Redear/LeoGamer/Gamer.jpg

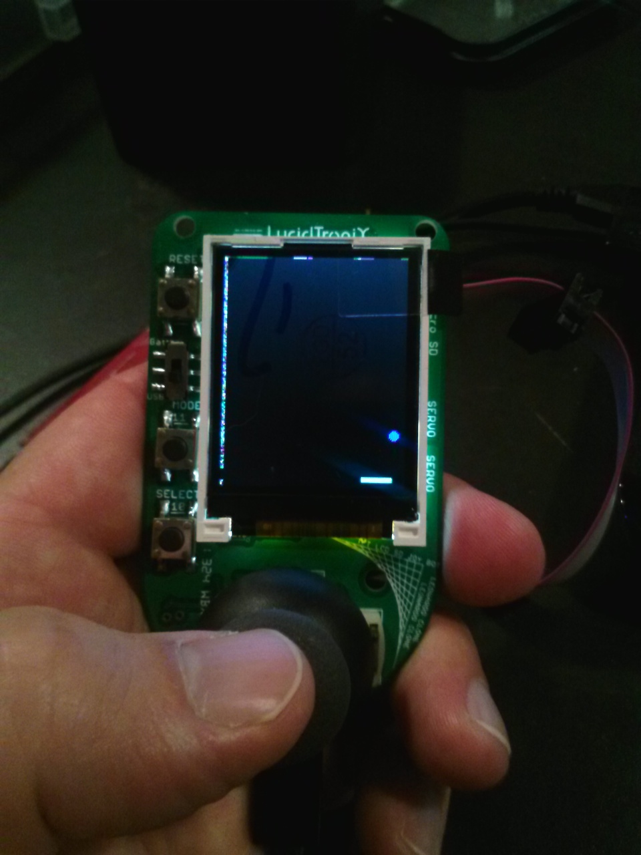
Gamer.jpg
