Redear/LeoGamer/README.md

LeoGamer
========

Arduino Leonardo based gaming system with joystick and MicroSD Card
