Redear/LeoGamer/ST7735.h.png

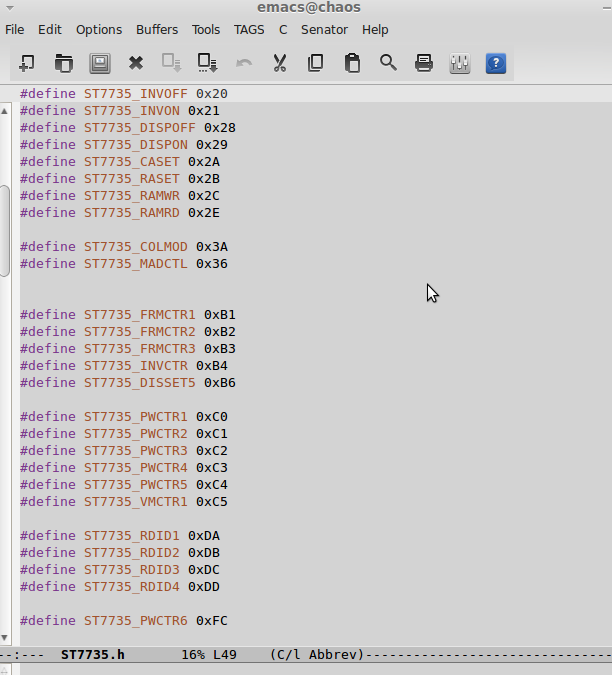
ST7735.h.png
