Redear/LeoGamer/(list of files, cad)

Other CAD files:
meshes/leo_gamer_piezo_hand.blend
meshes/leo_gamer_piezo_hand2.blend
