Redear/LeoGamer/eagle/leo_joy_gamer_v2.brd

## EAGLE design eagle/leo_joy_gamer_v2.brd (2013-09-10)

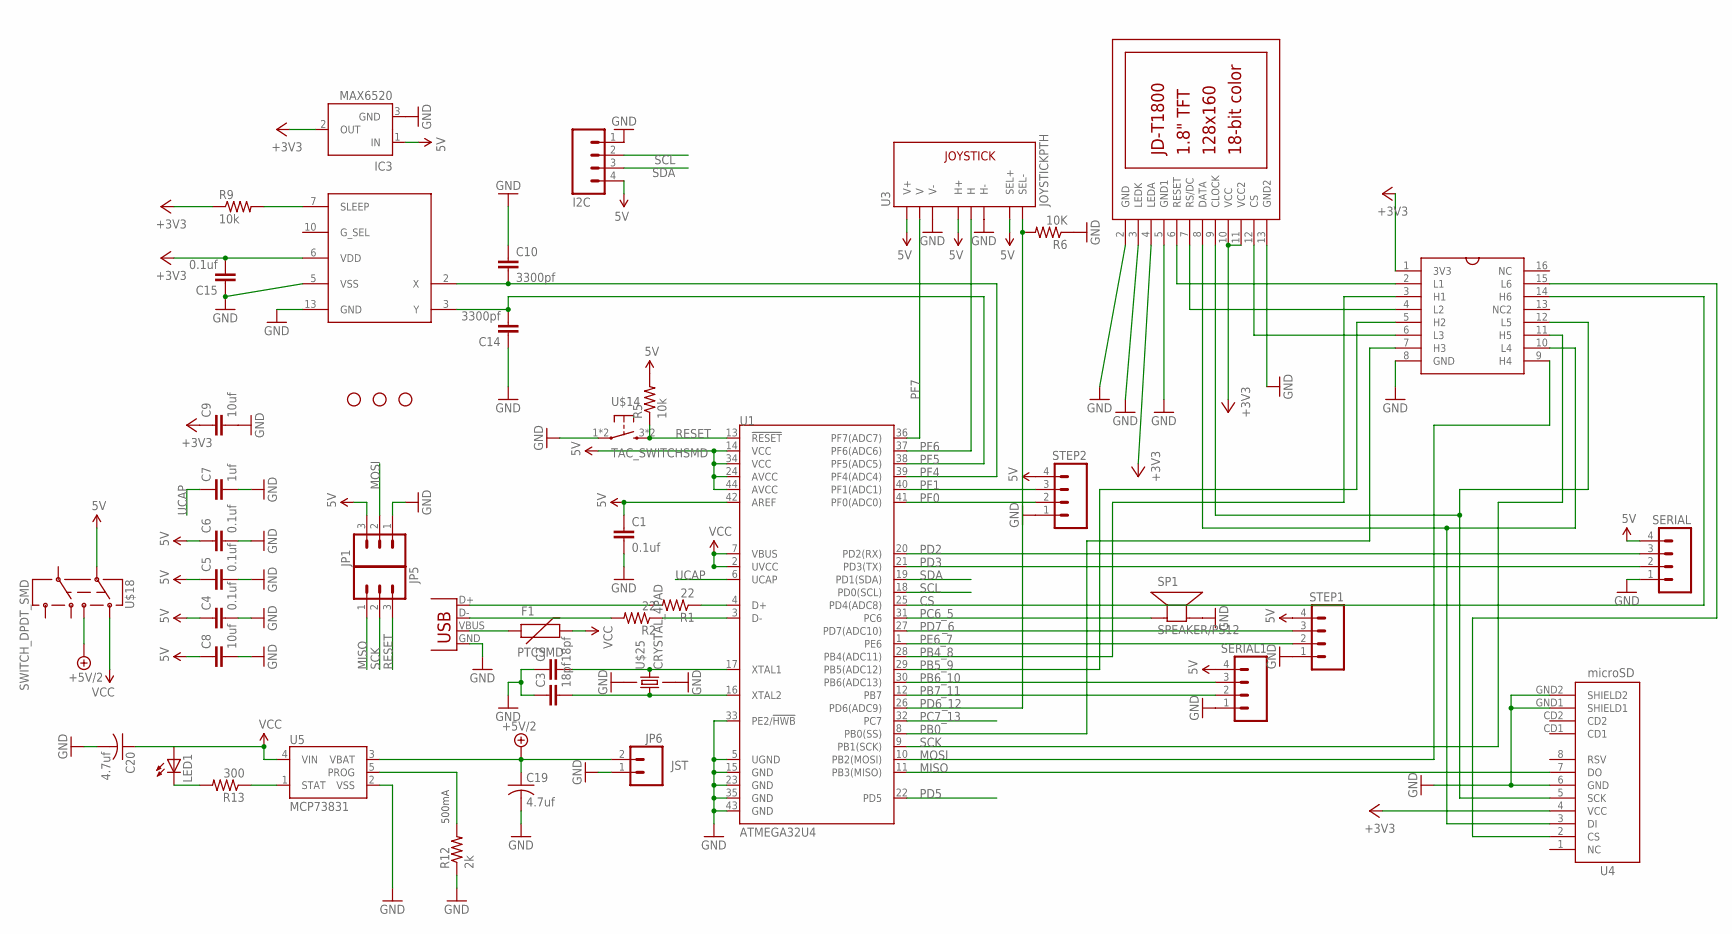
[picture p3: schematic leo_joy_gamer_v2.sch]

Parts:
C1, C4, C5, C6, C15: 0.1uf; 0805
C2, C3: 18pf; 0805
C7: 1uf; 0805
C8, C9: 10uf; 0805
C10, C14: 3300pf; 0805
C19, C20: 4.7uf; C0603
F1: PTCSMD; PTC-1206
I2C: M04LOCK; 1X04_LOCK
IC3: MAX6520; SOT23
JP1, JP5: M03LOCK; 1X03_LOCK
JP2, JP3, JP4: STAND-OFF
JP6: JST; JST-2-PTH
LCD1: JD-T1800
LED1: LEDCHIPLED_1206; CHIPLED_1206
R1, R2: 22; M0805
R5: 10k; M0805
R6: 10K; R0603
R9: 10k; R0805
R12: 2k; R0805
R13: 300; R0805
SERIAL, SERIAL1: M04LOCK; 1X04_LOCK
SP1: SPEAKER/PS12; PS12
STEP1, STEP2: M04LOCK; 1X04_LOCK
U1: ATMEGA32U4; QFN-44-NOPAD
U3: JOYSTICKPTH; JOYSTICK
U4: microSD; MICRO-SD-SOCKET-PP
U5: MCP73831; SOT23-5
U$2: CD4050SO_16_MIDDLE; SO_16
U$12: ACCELEROMETER_MMA6331L; LGA14
U$14: TAC_SWITCHSMD; TAC_SWITCH_SMD
U$18: SWITCH_DPDT_SMD; SWITCH_DPDT
U$25: CRYSTAL_4PAD; CRYSTAL_4PAD_TINY
X1: USBSMD; USB-MINIB

Connections:
5V: C1.1, C4.1, C5.1, C6.1, C8.1, I2C.4, IC3.1 (IN), JP1.3, R5.2, SERIAL.4, SERIAL1.4, STEP1.4, STEP2.4, U1.14 (VCC), U1.24 (AVCC), U1.34 (VCC), U1.42 (AREF), U1.44 (AVCC), U3.B1A (SEL+), U3.H1 (H+), U3.V1 (V+), U$18.7 (2)
+3V3: C9.1, C15.2, IC3.2 (OUT), LCD1.4 (LEDA), LCD1.10 (VCC), LCD1.11 (VCC2), R9.1, U4.4 (VCC), U$2.1 (3V3), U$12.6 (VDD)
+5V/2: C19.1, JP6.2, U5.3 (VBAT), U$18.8 (3)
CS: U1.25 (PD4(ADC8)), U$2.14 (H6)
D+: R1.2, X1.D+
D-: R2.2, X1.D-
GND: C1.2, C2.1, C3.1, C4.2, C5.2, C6.2, C7.2, C8.2, C9.2, C10.1, C14.1, C15.1, C19.2, C20.2, I2C.1, IC3.3 (GND), JP1.1, JP6.1, LCD1.2 (GND), LCD1.3 (LEDK), LCD1.5 (GND1), LCD1.13 (GND2), R6.1, R12.1, SERIAL.1, SERIAL1.1, SP1.P$2 (-), STEP1.1, STEP2.1, U1.5 (UGND), U1.15 (GND), U1.23 (GND), U1.33 (PE2/!HWB), U1.35 (GND), U1.43 (GND), U3.H3 (H-), U3.V3 (V-), U4.6 (GND), U4.GND1 (SHIELD1), U4.GND2 (SHIELD2), U5.2 (VSS), U$2.8 (GND), U$12.5 (VSS), U$12.13 (GND), U$14.1, U$14.2 (1), U$25.2 (GND2), U$25.4 (GND4), X1.GND
MISO: JP5.1, U1.11 (PB3(MISO)), U4.7 (DO)
MOSI: JP1.2, U1.10 (PB2(MOSI)), U$2.9 (H4)
MOSI_3V3: LCD1.8 (DATA), U4.3 (DI), U$2.10 (L4)
unnamed: LCD1.6 (RESET), U$2.2 (L1)
unnamed: C2.2, U1.17 (XTAL1), U$25.3
unnamed: C3.2, U1.16 (XTAL2), U$25.1
unnamed: LCD1.7 (RS/DC), U$2.4 (L2)
unnamed: LCD1.12 (CS), U$2.6 (L3)
unnamed: R1.1, U1.4 (D+)
unnamed: U4.2 (CS), U$2.15 (L6)
unnamed: R2.1, U1.3 (D-)
unnamed: R9.2, U$12.7 (SLEEP)
unnamed: R13.1, U5.1 (STAT)
unnamed: LED1.C, R13.2
PB0: U1.8 (PB0(SS)), U$2.7 (H3)
PB4_8: U1.28 (PB4(ADC11)), U$2.3 (H1)
PB5_9: U1.29 (PB5(ADC12)), U$2.5 (H2)
PB6_10: SERIAL1.3, U1.30 (PB6(ADC13))
PB7_11: SERIAL1.2, U1.12 (PB7)
PC6_5: SP1.P$1 (+), U1.31 (PC6)
PC7_13: U1.32 (PC7)
PD2: SERIAL.3, U1.20 (PD2(RX))
PD3: SERIAL.2, U1.21 (PD3(TX))
PD5: U1.22 (PD5)
PD6_12: R6.2, U1.26 (PD6(ADC9)), U3.B2A (SEL-)
PD7_6: STEP1.3, U1.27 (PD7(ADC10))
PE6_7: STEP1.2, U1.1 (PE6)
PF0: STEP2.2, U1.41 (PF0(ADC0))
PF1: STEP2.3, U1.40 (PF1(ADC1))
PF4: C10.2, U1.39 (PF4(ADC4)), U$12.2 (X)
PF5: C14.2, U1.38 (PF5(ADC5)), U$12.3 (Y)
PF6: U1.37 (PF6(ADC6)), U3.H2 (H)
PF7: U1.36 (PF7(ADC7)), U3.V2 (V)
PROG: R12.2, U5.5 (PROG)
RESET: JP5.3, R5.1, U1.13 (!RESET), U$14.3, U$14.4 (3)
SCK: JP5.2, U1.9 (PB1(SCK)), U$2.11 (H5)
SCK_3V3: LCD1.9 (CLOCK), U4.5 (SCK), U$2.12 (L5)
SCL: I2C.2, U1.18 (PD0(SCL))
SDA: I2C.3, U1.19 (PD1(SDA))
UCAP: C7.1, U1.6 (UCAP)
VBUS: F1.1, X1.VBUS
VCC: C20.1, F1.2, LED1.A, U1.2 (UVCC), U1.7 (VBUS), U5.4 (VIN), U$18.1

Notes on the sheet:
500mA

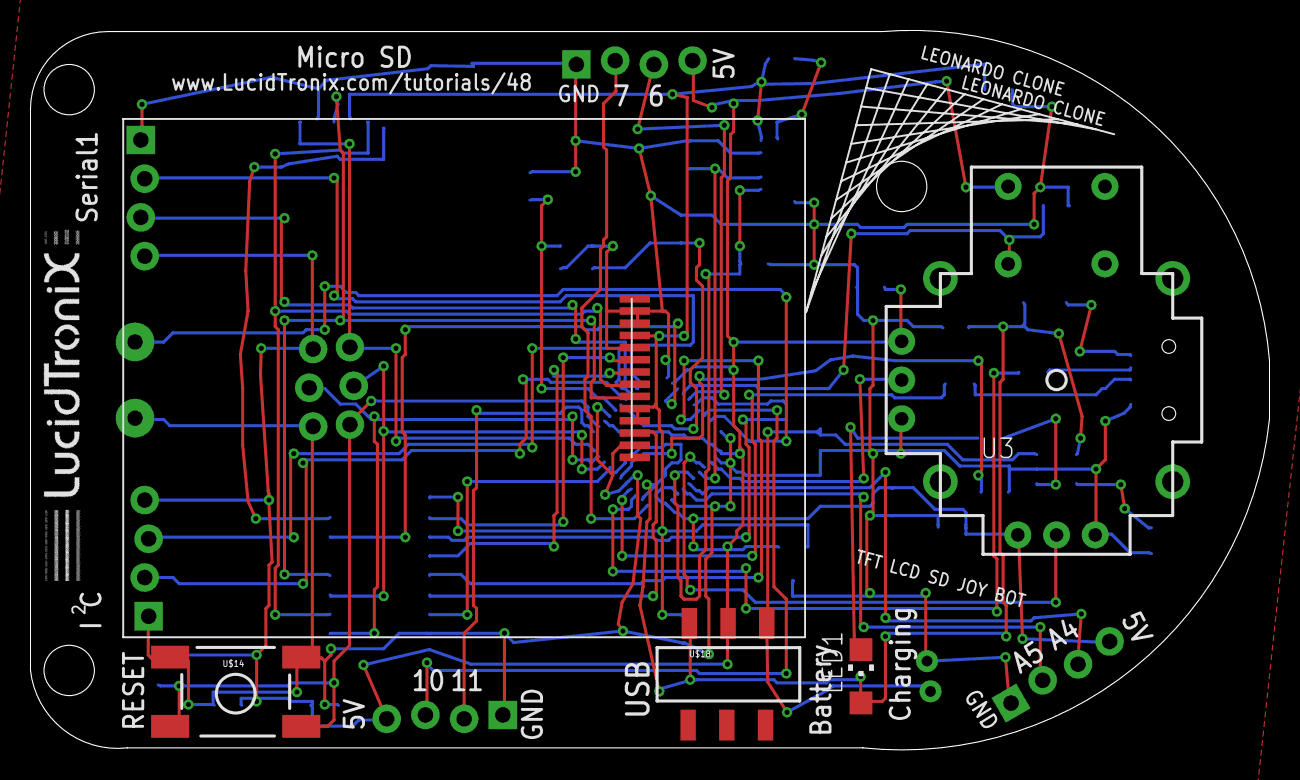
[picture p4: board leo_joy_gamer_v2.brd from above]

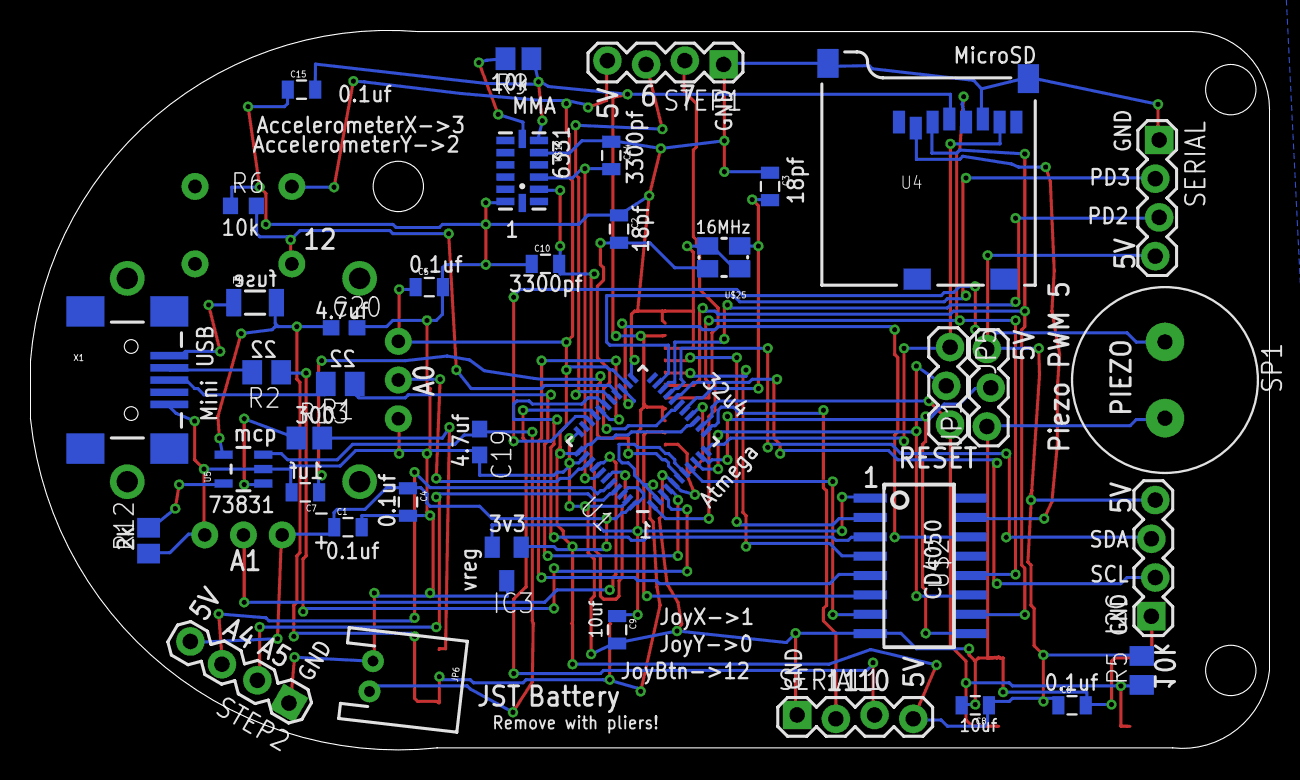
[picture p5: board leo_joy_gamer_v2.brd from below]

Board: 2 copper layers, 81.3 x 47.2 mm, 48 parts (39 on the bottom side), 47 nets.

Other parts of the board:
U$6: LUCIDTRONIX_LOGO_.75_INCH
