Redear/LeoGamer/(commit log)

2013-08-01 arduino files added
2013-08-01 added eagle files
    [leo_joy_gamer.brd, leo_joy_gamer.sch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]
2013-09-09 Put in explosion and collision detection
    [Target.cpp, Target.h, meteorAttack.ino]
2013-09-10 added meshes and eagle CAD
    [leo_gamer_piezo_hand.blend, leo_joy_gamer.brd, leo_joy_gamer.sch, leo_joy_gamer_v2.brd, leo_joy_gamer_v2.sch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]
2013-09-14 accelerometer mouse
2013-09-14 added leo gamer mesh 2
    [leo_gamer_piezo_hand2.blend]
