Redear/LeoGamer/(notices)

Notices in the files:
arduino/meteorAttack/meteorAttack.ino:
meteorAttack.ino is free software: you can redistribute it and/or modify
it under the terms of the GNU version 3 General Public License as
published by the Free Software Foundation.
